zeyad-hisham-cyper/Solar-IoT-Smart-Irrigation-System/PCBs/fritzing/main controler_bb.png

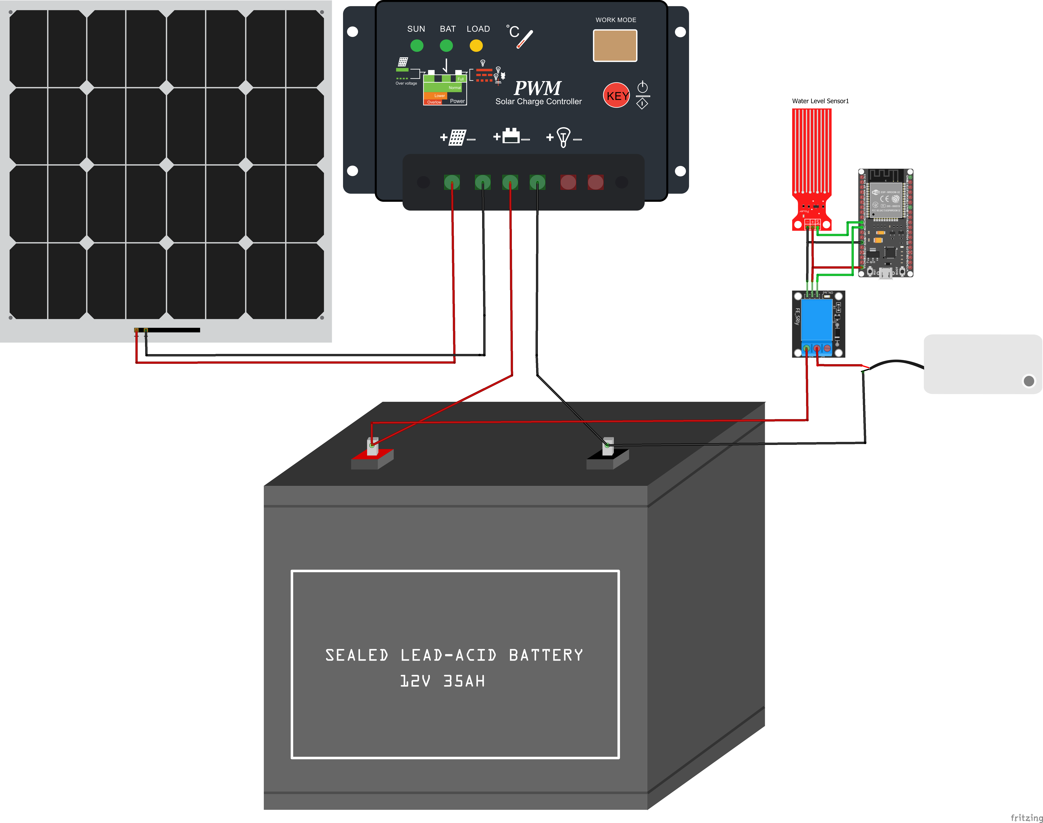
PCBs/fritzing/main controler_bb.png
