zeyad-hisham-cyper/Solar-IoT-Smart-Irrigation-System/PCBs/fritzing/zone_bb.png

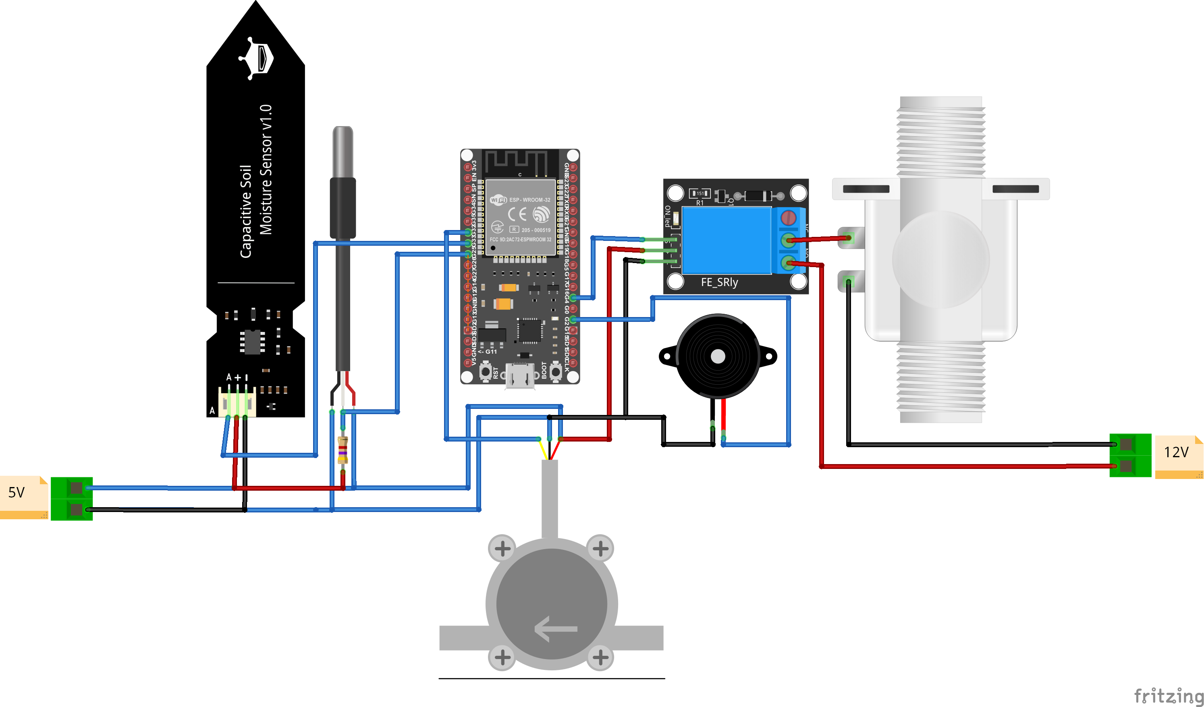
PCBs/fritzing/zone_bb.png
