zeyad-hisham-cyper/Solar-IoT-Smart-Irrigation-System/PCBs/BOM/Smart_Irrigation_BOM_PoC_Final.xlsx

Sheet: BOM_Items
Subsystem | Item No. | Component Name | Part Number / Model (PoC) | Part Number / Model (Final) | Description / Specs | Quantity (per unit) | Total Units | Unit Price (PoC) (USD) | Total Cost (PoC) (USD) | Unit Price (Final) (USD) | Total Cost (Final) (USD) | Vendor / Source | Notes
Control Unit | 1 | ESP32 Dev Board | ESP32 Dev Kit (PoC) | ESP32-PICO / STM32 on custom PCB (Final) | Wi-Fi + MCU for gateway / controller | 1 | 1 | 7 | 7 | 8 | 8 |  | PoC: off-the-shelf devboard; Final: custom PCB
Control Unit | 2 | Relay Module / MOSFET | 1-ch Relay module (PoC) | Industrial MOSFET / SSR (Final) | Drive solenoid valves (ON/OFF) | 1 | 1 | 3 | 3 | 12 | 12 |  | Final: more robust driver
Control Unit | 3 | Enclosure (gateway) | Plastic project box (PoC) | IP65 metal/plastic enclosure (Final) | Housing for control unit | 1 | 1 | 5 | 5 | 25 | 25 |  | Outdoor rated for final
Node | 10 | Soil Moisture Sensor (cheap PoC) | Capacitive module (cheap) | Industrial capacitive / VH400 (Final) | Soil moisture sensor | 1 | 2 | 2 | 4 | 60 | 120 |  | PoC cheap sensor vs calibrated industrial sensor
Node | 11 | Temperature / Humidity Sensor | DHT11 (PoC) | SHT31 / Si7021 (Final) | Ambient temp & humidity | 1 | 2 | 2.5 | 5 | 12 | 24 |  | Optional but recommended
Node | 12 | Local MCU (node) | ESP32 Dev Board (PoC node) | Low-power MCU (Final) | Node controller, wireless comms | 1 | 2 | 7 | 14 | 6.5 | 13 |  | Final may be optimized for power
Node | 13 | Solenoid Valve | 12V solenoid valve (PoC) | IP67 12V solenoid valve (Final) | Water valve per zone (ON/OFF) | 1 | 2 | 15 | 30 | 40 | 80 |  | Check valve current and flow specs
Node | 14 | Tubing & Fittings | Basic PVC tubing (PoC) | UV-resistant tubing + fittings (Final) | Irrigation tubing and connectors | 1 | 2 | 4 | 8 | 12 | 24 |  | Quantity depends on layout
Power | 20 | Solar Panel (PoC) | 5V 2W small panel (PoC) | 6V 10W (Final, per node) | Pmax ~2W, Vmp~5V (PoC) / Final panels higher power | 1 | 1 | 8 | 8 | 28 | 28 |  | PoC: single panel for prototype; Final: per-node panels
Power | 21 | Battery (PoC) | 18650 + holder (PoC) | LiFePO4 pack / 18650 pack (Final) | Energy storage for night/low sun | 1 | 1 | 6 | 6 | 30 | 30 |  | Final: larger capacity and BMS
Power | 22 | Charging / Power Management | TP4056 charger (PoC) | MPPT / Solar charge controller (Final) | Ensure safe charging and efficiency | 1 | 1 | 1 | 1 | 18 | 18 |  | Final: MPPT recommended for efficiency
Power | 23 | Blocking Diode / Fuse | Schottky diode, polyfuse (PoC) | Industrial fuse + blocking diode (Final) | Protect from reverse current and faults | 1 | 2 | 1 | 2 | 3 | 6 |  | Per node in final
Comm | 30 | Gateway (if LoRa) or Router (if Wi-Fi) | Use control unit as gateway (PoC) | Commercial LoRa gateway or router (Final) | Central communication gateway | 1 | 1 | 0 | 0 | 150 | 150 |  | Only if using LoRa or wide-area comms
Mechanical | 40 | IP65 Junction Box (node) | Small plastic box (PoC) | IP65 junction box (Final) | Protect electronics at node | 1 | 2 | 3 | 6 | 15 | 30 |  | Weatherproofing is important
Mechanical | 41 | Connectors & Cables | Dupont / jumper wires (PoC) | Waterproof cable glands, JST/M12 (Final) | Cables and connectors for sensors/valves | 1 | 2 | 2 | 4 | 8 | 16 |  | Depends on distances
Mechanical | 42 | PCB (Control Unit) - fabrication | NA (PoC breadboarded) | Custom PCB fabrication & assembly (Final) | Custom PCB for control unit | 1 | 1 | 0 | 0 | 40 | 40 |  | Final: includes assembly
Cloud/App | 50 | Cloud hosting (monthly credits) | Free tier / local testing (PoC) | Cloud instance / DB / MQTT (Final) | Cloud resources for telemetry and storage | 1 | 1 | 0 | 0 | 10 | 10 |  | Estimate per month
Cloud/App | 51 | Mobile App / Software | Prototype app (PoC) | Production app / maintenance (Final) | Development / deployment cost estimate | 1 | 1 | 0 | 0 | 200 | 200 |  | If hiring devs or using paid platforms

Sheet: Summary
Description | Value
Prototype Zones | 2
Control Units | 1
Total PoC Cost (USD) | 103
Total Final Cost (USD) (est) | 834

Sheet: Next_Steps_Checklist
Step | Done
Confirm communication technology (Wi-Fi / LoRa / NB-IoT) | FALSE
Gather exact solenoid valve model & current draw | FALSE
Decide battery chemistry (Li-ion vs LiFePO4) | FALSE
Select solar panel power per node (Wp) for final | FALSE
Design control unit PCB (final) | FALSE
Estimate packaging and mounting costs | FALSE

Sheet: Prices_to_Fill
Item No. | Component Name | Preferred Vendor | Currency | Unit Price | Lead Time (days)
