zeyad-hisham-cyper/Solar-IoT-Smart-Irrigation-System/PCBs/fritzing/light.csv

Reference | Qty | Value
C1 | 1 | 100u
C2,C4,C5 | 3 | 100n
C3 | 1 | 470u
D1,D2,D3,D4,D5,D6,D7,D8,D9,D10,D11,D12,D13,D14,D15,D16 | 16 | LED
D17,D18,D19,D20 | 4 | 1N4007
J1,J2,J3,J4,J8 | 5 | Screw_Terminal_01x02
J5,J6 | 2 | Conn_01x15_Pin
K1,K2,K3,K4 | 4 | SRD-12VDC-SL-C
Q1,Q2,Q3,Q4 | 4 | 2n2222
R1 | 1 | 1K
R2,R3,R4,R5,R6,R7,R8,R9,R10,R11,R12,R13,R14,R15,R16,R17,R21,R25,R26 | 19 | 1k
R18,R20,R23,R24 | 4 | 680
R19,R22,R27,R28 | 4 | 100k
S1 | 1 | TL2285EE
U1,U2 | 2 | 74HC595
U3 | 1 | NodeMCU1.0(ESP-12E)
U4 | 1 | YAAJ_DCDC_StepDown_LM2596
U5,U8,U9,U10 | 4 | PC817
