zeyad-hisham-cyper/Solar-IoT-Smart-Irrigation-System/PCBs/control/control.csv

Reference | Qty | Value
BZ1 | 1 | Buzzer
C1 | 1 | 100u
C2,C5 | 2 | 100n
C3,C4 | 2 | 470u
D1 | 1 | 1N4007
D4,D5,D6 | 3 | LED
J1,J8 | 2 | Screw_Terminal_01x02
J3 | 1 | Conn_01x03_Socket
J6,J7 | 2 | Conn_01x19_Pin
Q1 | 1 | Q_NMOS_GDS
Q2 | 1 | BC547
R1 | 1 | 10k
R2 | 1 | 100
R3 | 1 | 4.7k
R4 | 1 | 100k
R5,R6,R7 | 3 | 220
S1 | 1 | TL2285EE
U1 | 1 | ESP32-DEVKITC-32E
U2 | 1 | YAAJ_DCDC_StepDown_LM2596
