zeyad-hisham-cyper/Solar-IoT-Smart-Irrigation-System/PCBs/Zone/Zone.csv

Reference | Qty | Value
C2,C4,C5 | 3 | 100n
C1 | 1 | 100u
C3 | 1 | 470u
R5,R6,R7 | 3 | 220
R1,R3 | 2 | 1k
R4 | 1 | 4.7k
R8 | 1 | 10k
D1 | 1 | 1N4007
Q1 | 1 | BC547
BZ1 | 1 | Buzzer
J2,J3,J5 | 3 | Conn_01x03_Socket
J6,J7 | 2 | Conn_01x19_Pin
U1 | 1 | ESP32-DEVKITC-32E
D2,D4,D5,D6 | 4 | LED
J1,J8 | 2 | Screw_Terminal_01x02
K2 | 1 | SRD-05VDC-SL-C
SW1 | 1 | SW_Push
S1 | 1 | TL2285EE
U2 | 1 | YAAJ_DCDC_StepDown_LM2596
