zeyad-hisham-cyper/Solar-IoT-Smart-Irrigation-System/(list of files, drawings)

Other design files:
PCBs/fritzing/main controler.fzz
PCBs/fritzing/zone.fzz
