zeyad-hisham-cyper/Solar-IoT-Smart-Irrigation-System/PCBs/light/light.kicad_pcb

## KiCad design PCBs/light/light.kicad_pcb (2026-10-20)

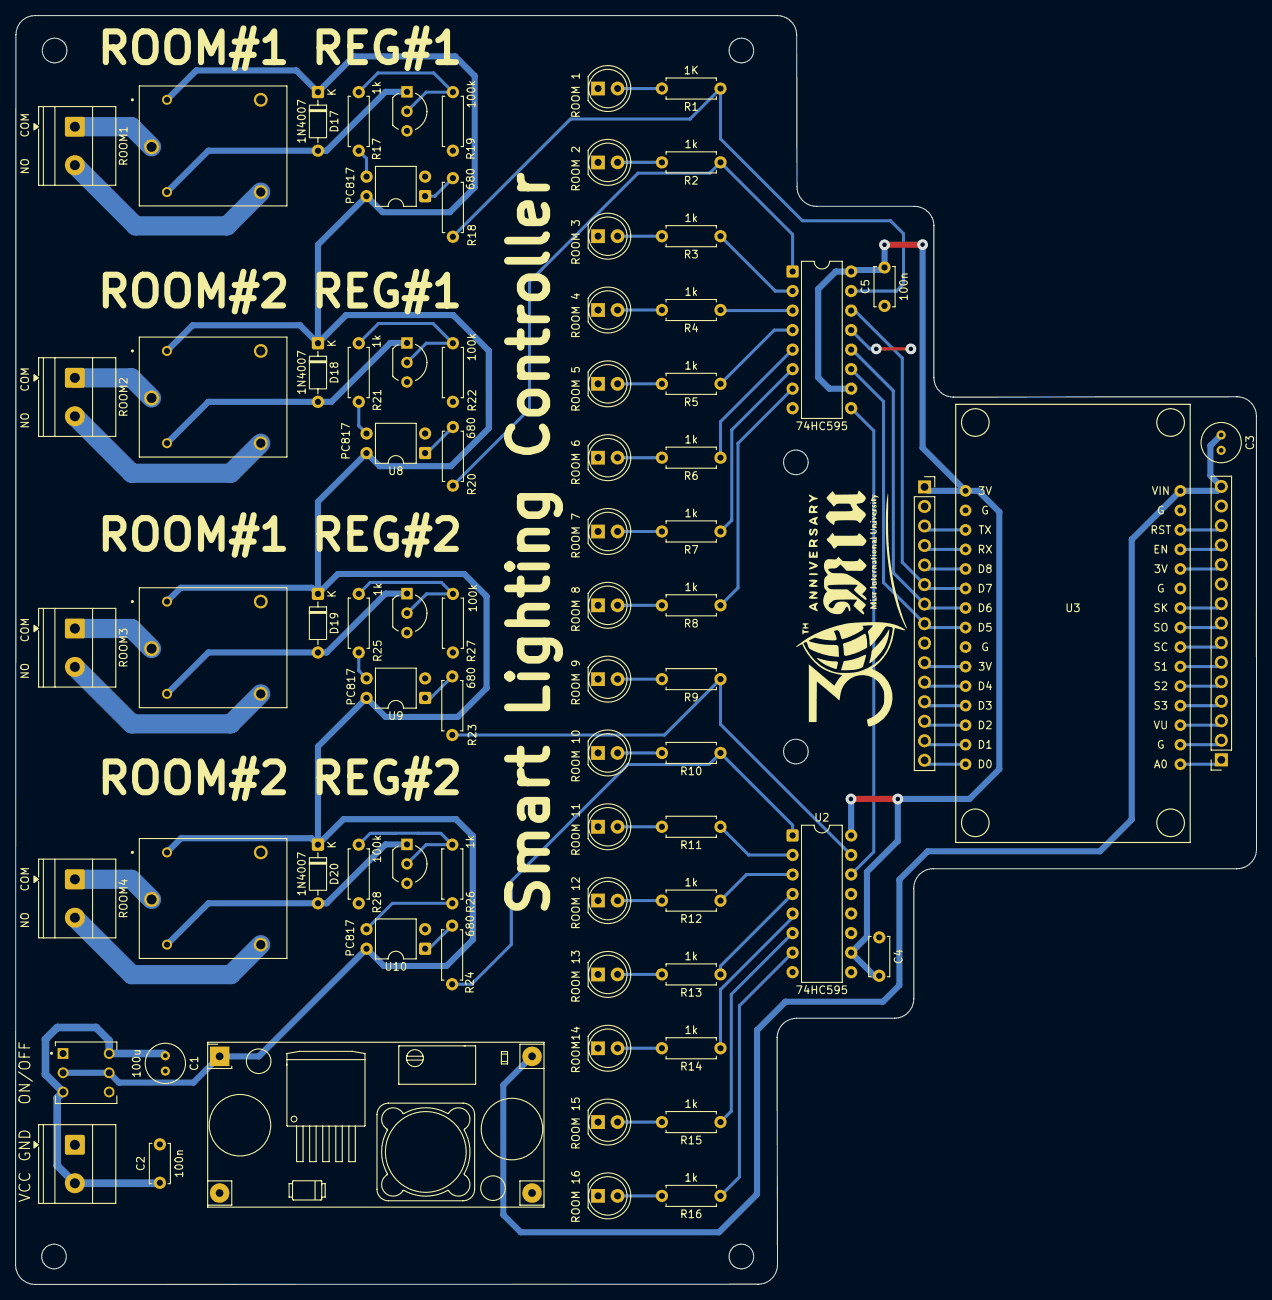
[picture p8: board light.kicad_pcb from above]

Board: 2 copper layers, 161.4 x 165.0 mm, 77 parts (0 on the bottom side), 86 nets.

Parts:
C1: 100u; C_Radial_D5.0mm_H5.0mm_P2.00mm
C2, C4, C5: 100n; C_Disc_D5.0mm_W2.5mm_P5.00mm
C3: 470u; C_Radial_D5.0mm_H5.0mm_P2.00mm
D17, D18, D19, D20: 1N4007; D_DO-35_SOD27_P7.62mm_Horizontal
J5, J6: Conn_01x15_Pin; PinSocket_1x15_P2.54mm_Vertical
J8: Screw_Terminal_01x02; TerminalBlock_Phoenix_MKDS-1,5-2_1x02_P5.00mm_Horizontal
K1, K2, K3, K4: SRD-12VDC-SL-C; RELAY_SRD-12VDC-SL-C
ON/OFF: TL2285EE; SW_TL2285EE
Q1, Q2, Q3, Q4: 2n2222; TO-92_Inline_Wide
R1: 1K; R_Axial_DIN0207_L6.3mm_D2.5mm_P7.62mm_Horizontal
R2, R3, R4, R5, R6, R7, R8, R9, R10, R11, R12, R13, R14, R15, R16, R17, R21, R25, R26: 1k; R_Axial_DIN0207_L6.3mm_D2.5mm_P7.62mm_Horizontal
R18, R20, R23, R24: 680; R_Axial_DIN0207_L6.3mm_D2.5mm_P7.62mm_Horizontal
R19, R22, R27, R28: 100k; R_Axial_DIN0207_L6.3mm_D2.5mm_P7.62mm_Horizontal
ROOM1, ROOM2, ROOM3, ROOM4: Screw_Terminal_01x02; TerminalBlock_Phoenix_MKDS-1,5-2_1x02_P5.00mm_Horizontal
ROOM14: LED; LED_D5.0mm
ROOM 1, ROOM 2, ROOM 3, ROOM 4, ROOM 5, ROOM 6, ROOM 7, ROOM 8, ROOM 9, ROOM 10, ROOM 11, ROOM 12, ROOM 13, ROOM 15, ROOM 16: LED; LED_D5.0mm
U1, U2: 74HC595; DIP-16_W7.62mm
U3: NodeMCU1.0(ESP-12E); NodeMCU-LoLinV3
U4: YAAJ_DCDC_StepDown_LM2596
U5, U8, U9, U10: PC817; DIP-4_W7.62mm

Connections:
5V: C3.1, J5.15, U3.15 (VIN), U4.4 (Vout)
+3.3V: C4.2, C5.2, J6.1, U1.10 (~SRCLR), U1.16 (VCC), U2.10 (~SRCLR), U2.16 (VCC), U3.16 (3.3V)
+12V: D17.1 (K), D18.1 (K), D19.1 (K), D20.1 (K), K1.COIL1, K2.COIL1, K3.COIL1, K4.COIL1, ON/OFF.2, ON/OFF.5, U4.1 (Vin), U5.4, U8.4, U9.4, U10.4
+12V_IN: C1.1, C2.1, J8.2, ON/OFF.3, ON/OFF.4
/relay_module/COM1: K1.COM, ROOM1.1
/relay_module/COM2: K2.COM, ROOM2.1
/relay_module/COM3: K3.COM, ROOM3.1
/relay_module/COM4: K4.COM, ROOM4.1
/relay_module/NO1: K1.NO, ROOM1.2
/relay_module/NO2: K2.NO, ROOM2.2
/relay_module/NO3: K3.NO, ROOM3.2
/relay_module/NO4: K4.NO, ROOM4.2
CLOCK: J6.8, U1.11 (SRCLK), U3.23 (D5(GPIO14))
DATA: J6.6, U1.14 (SER), U3.21 (D7(GPIO13))
GND: C1.2, C2.2, C3.2, C4.1, C5.1, J5.10, J5.14, J6.2, J6.9, J8.1, Q1.3 (E), Q2.3 (E), Q3.3 (E), Q4.3 (E), R19.1, R22.1, R27.1, R28.1, ROOM14.1 (K), ROOM 1.1 (K), ROOM 2.1 (K), ROOM 3.1 (K), ROOM 4.1 (K), ROOM 5.1 (K), ROOM 6.1 (K), ROOM 7.1 (K), ROOM 8.1 (K), ROOM 9.1 (K), ROOM 10.1 (K), ROOM 11.1 (K), ROOM 12.1 (K), ROOM 13.1 (K), ROOM 15.1 (K), ROOM 16.1 (K), U1.8 (GND), U1.13 (~OE), U2.8 (GND), U2.13 (~OE), U3.10 (GND), U3.14 (GND), U3.17 (GND), U3.24 (GND), U4.2 (GND), U4.3 (GND), U5.2, U8.2, U9.2, U10.2
LATCH: J6.7, U1.12 (RCLK), U3.22 (D6(GPIO12))
unnamed: R1.2, ROOM 1.2 (A)
unnamed: R2.2, ROOM 2.2 (A)
unnamed: R3.2, ROOM 3.2 (A)
unnamed: R4.2, ROOM 4.2 (A)
unnamed: R5.2, ROOM 5.2 (A)
unnamed: R6.2, ROOM 6.2 (A)
unnamed: R7.2, ROOM 7.2 (A)
unnamed: R8.2, ROOM 8.2 (A)
unnamed: R9.2, ROOM 9.2 (A)
unnamed: R10.2, ROOM 10.2 (A)
unnamed: R11.2, ROOM 11.2 (A)
unnamed: R12.2, ROOM 12.2 (A)
unnamed: R13.2, ROOM 13.2 (A)
unnamed: R14.2, ROOM14.2 (A)
unnamed: R15.2, ROOM 15.2 (A)
unnamed: R16.2, ROOM 16.2 (A)
unnamed: D17.2 (A), K1.COIL2, Q1.1 (C)
unnamed: D18.2 (A), K2.COIL2, Q2.1 (C)
unnamed: D19.2 (A), K3.COIL2, Q3.1 (C)
unnamed: D20.2 (A), K4.COIL2, Q4.1 (C)
unnamed: J5.1, U3.1 (A0(ADC0))
unnamed: J5.2, U3.2 (RSV)
unnamed: J5.3, U3.3 (RSV)
unnamed: J5.4, U3.4 (SD3(GPIO10))
unnamed: J5.5, U3.5 (SD2(GPIO9))
unnamed: J5.6, U3.6 (SD1(MOSI))
unnamed: J5.7, U3.7 (CMD(CS))
unnamed: J5.8, U3.8 (SDO(MISO))
unnamed: J5.9, U3.9 (CLK(SCLK))
unnamed: J5.11, U3.11 (3.3V)
unnamed: J5.12, U3.12 (EN)
unnamed: J5.13, U3.13 (RST)
unnamed: J6.3, U3.18 (TX(GPIO1))
unnamed: J6.4, U3.19 (RX(DPIO3))
unnamed: J6.5, U3.20 (D8(GPIO15))
unnamed: J6.10, U3.25 (3.3V)
unnamed: J6.11, U3.26 (D4(GPIO2))
unnamed: J6.12, U3.27 (D3(GPIO0))
unnamed: J6.13, U3.28 (D2(GPIO4))
unnamed: J6.14, U3.29 (D1(GPIO5))
unnamed: J6.15, U3.30 (D0(GPIO16))
unnamed: Q1.2 (B), R17.2, R19.2
unnamed: Q2.2 (B), R21.2, R22.2
unnamed: Q3.2 (B), R25.2, R27.2
unnamed: Q4.2 (B), R26.2, R28.2
unnamed: R17.1, U5.3
unnamed: R18.2, U5.1
unnamed: R20.2, U8.1
unnamed: R21.1, U8.3
unnamed: R23.2, U9.1
unnamed: R24.2, U10.1
unnamed: R25.1, U9.3
unnamed: R26.1, U10.3
unnamed: U1.9 (QH'), U2.14 (SER)
OUT1: R1.1, R18.1, U1.15 (QA)
OUT2: R2.1, R20.1, U1.1 (QB)
OUT3: R3.1, U1.2 (QC)
OUT4: R4.1, U1.3 (QD)
OUT5: R5.1, U1.4 (QE)
OUT6: R6.1, U1.5 (QF)
OUT7: R7.1, U1.6 (QG)
OUT8: R8.1, U1.7 (QH)
OUT9: R9.1, R23.1, U2.15 (QA)
OUT10: R10.1, R24.1, U2.1 (QB)
OUT11: R11.1, U2.2 (QC)
OUT12: R12.1, U2.3 (QD)
OUT13: R13.1, U2.4 (QE)
OUT14: R14.1, U2.5 (QF)
OUT15: R15.1, U2.6 (QG)
OUT16: R16.1, U2.7 (QH)
