zeyad-hisham-cyper/Solar-IoT-Smart-Irrigation-System/PCBs/Zone/Zone.kicad_pcb

## KiCad design PCBs/Zone/Zone.kicad_pcb (2026-06-24)

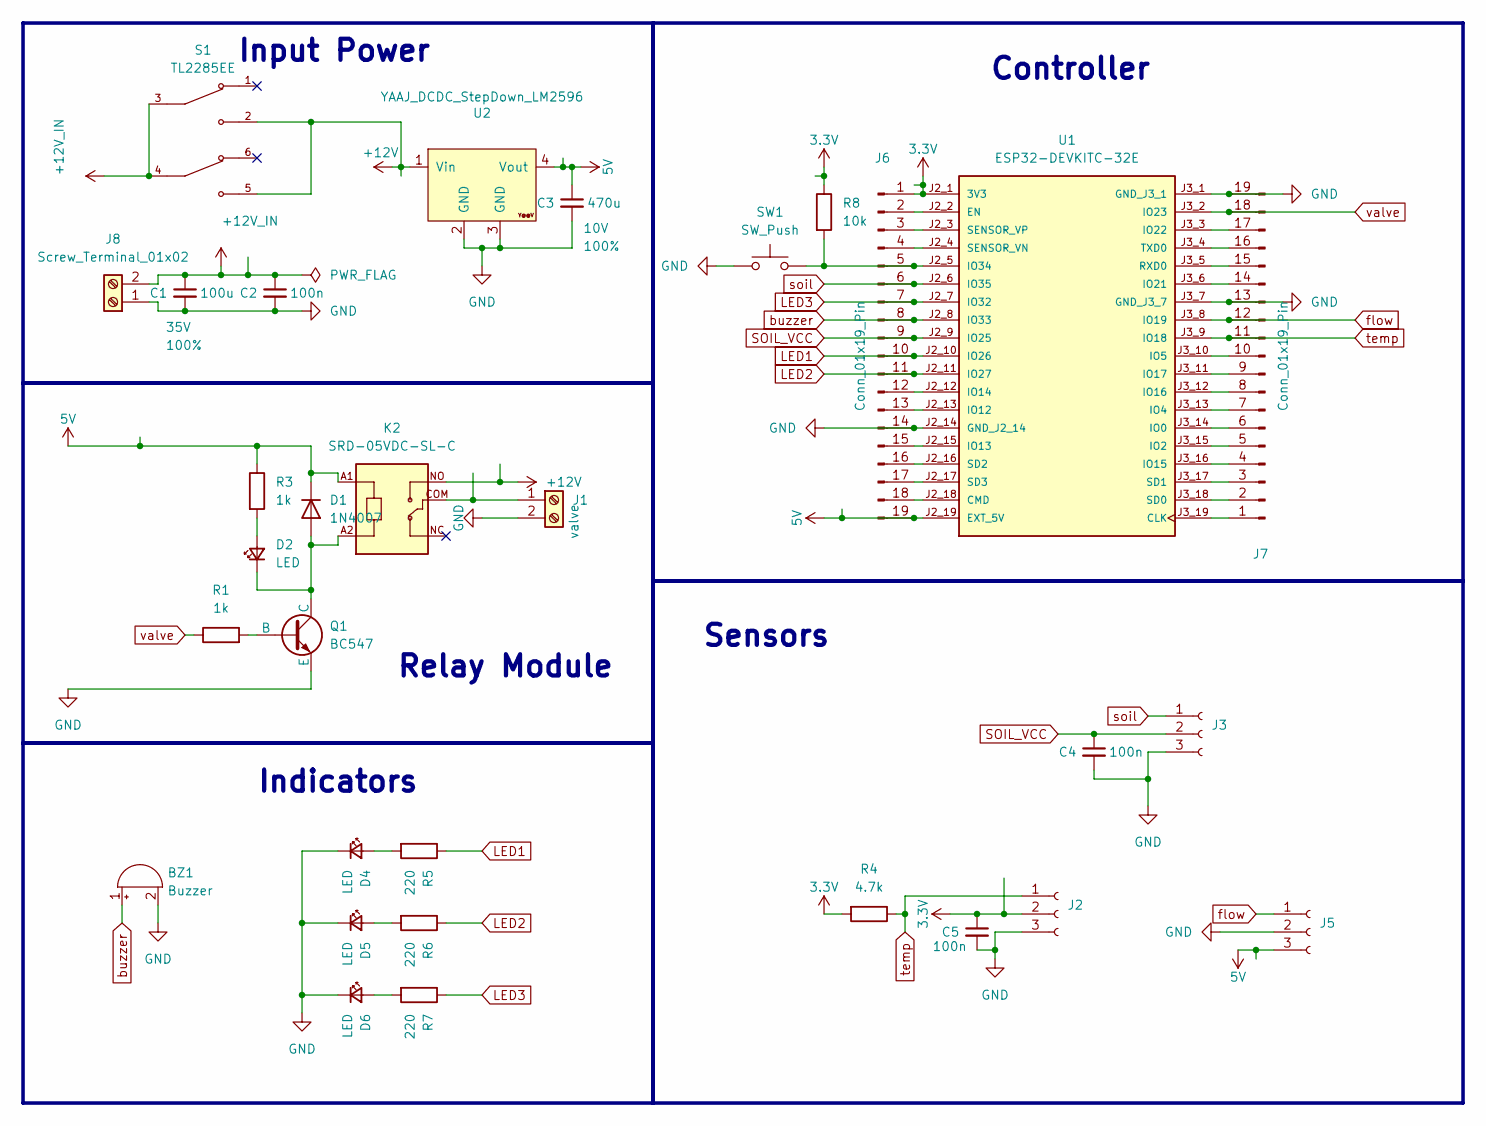
[picture p9: schematic Zone.kicad_sch]

Parts:
BZ1: Buzzer; Buzzer_12x9.5RM7.6
C1: 100u; C_Radial_D5.0mm_H5.0mm_P2.00mm; Voltage 35V; Tolerance 100%
C2, C4, C5: 100n; C_Disc_D5.0mm_W2.5mm_P5.00mm; Voltage 35V; Tolerance 100%
C3: 470u; C_Radial_D5.0mm_H5.0mm_P2.00mm; Voltage 10V; Tolerance 100%
D1: 1N4007; D_DO-35_SOD27_P7.62mm_Horizontal
D2, D4, D5, D6: LED; LED_D5.0mm
J1, J8: Screw_Terminal_01x02; TerminalBlock_Phoenix_MKDS-1,5-2_1x02_P5.00mm_Horizontal
J2, J3, J5: Conn_01x03_Socket; JST_XH_B3B-XH-A_1x03_P2.50mm_Vertical
J6, J7: Conn_01x19_Pin; PinSocket_1x19_P2.54mm_Vertical
K2: SRD-05VDC-SL-C; RELAY_SRD-05VDC-SL-C
Q1: BC547; TO-92_Inline_Wide
R1, R3: 1k; R_Axial_DIN0207_L6.3mm_D2.5mm_P7.62mm_Horizontal
R4: 4.7k; R_Axial_DIN0207_L6.3mm_D2.5mm_P7.62mm_Horizontal
R5, R6, R7: 220; R_Axial_DIN0207_L6.3mm_D2.5mm_P7.62mm_Horizontal
R8: 10k; R_Axial_DIN0207_L6.3mm_D2.5mm_P7.62mm_Horizontal
S1: TL2285EE; SW_TL2285EE; PARTREV B
SW1: SW_Push; SW_PUSH_6mm
U1: ESP32-DEVKITC-32E; MODULE_ESP32-DEVKITC-32E; PARTREV 1.4
U2: YAAJ_DCDC_StepDown_LM2596

Connections:
3.3V: C5.1, J2.2, J6.1, R4.2, R8.1, U1.J2_1 (3V3)
5V: C3.1, D1.1 (K), J5.3, J6.19, K2.A1, R3.1, U1.J2_19 (EXT_5V), U2.4 (Vout)
+12V: K2.NO, S1.2, S1.5, U2.1 (Vin)
+12V_IN: C1.1, C2.1, J8.2, S1.3, S1.4
GND: BZ1.2 (-), C1.2, C2.2, C3.2, C4.2, C5.2, D4.1 (K), D5.1 (K), D6.1 (K), J1.2, J2.3, J3.3, J5.2, J6.14, J7.13, J7.19, J8.1, Q1.3 (E), SW1.1, U1.J2_14 (GND_J2_14), U1.J3_1 (GND_J3_1), U1.J3_7 (GND_J3_7), U2.2 (GND), U2.3 (GND)
LED1: J6.10, R5.1, U1.J2_10 (IO26)
LED2: J6.11, R6.1, U1.J2_11 (IO27)
LED3: J6.7, R7.1, U1.J2_7 (IO32)
unnamed: D1.2 (A), D2.1 (K), K2.A2, Q1.1 (C)
unnamed: D2.2 (A), R3.2
unnamed: D4.2 (A), R5.2
unnamed: D5.2 (A), R6.2
unnamed: D6.2 (A), R7.2
unnamed: J1.1, K2.COM
unnamed: J6.2, U1.J2_2 (EN)
unnamed: J6.3, U1.J2_3 (SENSOR_VP)
unnamed: J6.4, U1.J2_4 (SENSOR_VN)
unnamed: J6.5, R8.2, SW1.2, U1.J2_5 (IO34)
unnamed: J6.12, U1.J2_12 (IO14)
unnamed: J6.13, U1.J2_13 (IO12)
unnamed: J6.15, U1.J2_15 (IO13)
unnamed: J6.16, U1.J2_16 (SD2)
unnamed: J6.17, U1.J2_17 (SD3)
unnamed: J6.18, U1.J2_18 (CMD)
unnamed: J7.1, U1.J3_19 (CLK)
unnamed: J7.2, U1.J3_18 (SD0)
unnamed: J7.3, U1.J3_17 (SD1)
unnamed: J7.4, U1.J3_16 (IO15)
unnamed: J7.5, U1.J3_15 (IO2)
unnamed: J7.6, U1.J3_14 (IO0)
unnamed: J7.7, U1.J3_13 (IO4)
unnamed: J7.8, U1.J3_12 (IO16)
unnamed: J7.9, U1.J3_11 (IO17)
unnamed: J7.10, U1.J3_10 (IO5)
unnamed: J7.14, U1.J3_6 (IO21)
unnamed: J7.15, U1.J3_5 (RXD0)
unnamed: J7.16, U1.J3_4 (TXD0)
unnamed: J7.17, U1.J3_3 (IO22)
unnamed: Q1.2 (B), R1.2
SOIL_VCC: C4.1, J3.2, J6.9, U1.J2_9 (IO25)
buzzer: BZ1.1 (+), J6.8, U1.J2_8 (IO33)
flow: J5.1, J7.12, U1.J3_8 (IO19)
soil: J3.1, J6.6, U1.J2_6 (IO35)
temp: J2.1, J7.11, R4.1, U1.J3_9 (IO18)
valve: J7.18, R1.1, U1.J3_2 (IO23)

Notes on the sheet:
Controller
Relay Module
Input Power
Indicators
Sensors

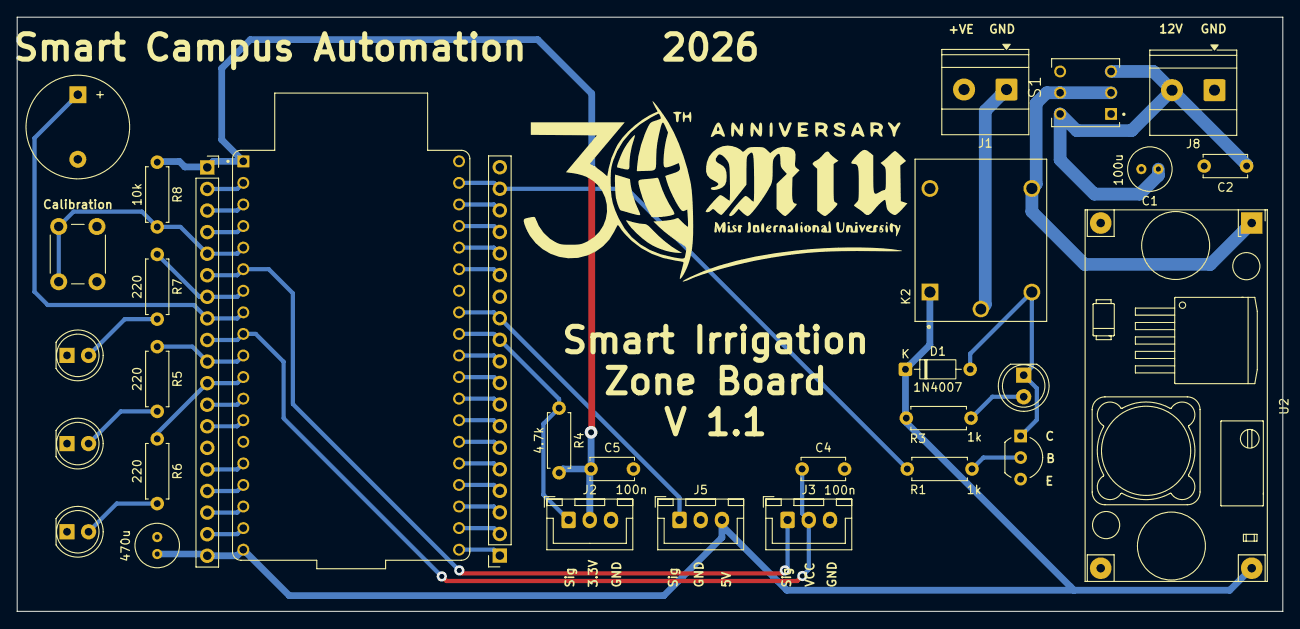
[picture p10: board Zone.kicad_pcb from above]

Board: 2 copper layers, 149.0 x 70.0 mm, 31 parts (0 on the bottom side), 45 nets.
