zeyad-hisham-cyper/Solar-IoT-Smart-Irrigation-System/(commit log)

2026-01-27 Adding Soil Moisture Driver
2026-01-31 Updating SMS Driver
2026-02-01 refine the sms sensor and add ds18b20 dependecies
2026-02-01 adding ds18b20 wrapper driver
2026-03-07 Drafting Cloud Lambda and add some addition drivers
2026-06-24 adding pcbs
2026-10-20 Move credentials to secrets.h, add lighting board, gerbers and Firebase model
    - Gateway credentials (Wi-Fi, OpenWeather, Firebase) now come from a git-ignored secrets.h; secrets.example.h is the template.
    - Add Smart Lighting relay board KiCad project, gerbers for all boards, Fritzing prototypes and PoC BOM.
    - Add Firebase RTDB data model, seed data and sample export.
    - Rewrite .gitignore so only technical work is published.
    - Drop duplicate LM2596 KiCad.zip.
    - README: document lighting board, new folders and secrets setup.
