zeyad-hisham-cyper/Solar-IoT-Smart-Irrigation-System/(notices)

Notices in the files:
README.md:
License: MIT
